TruongTanNghia/xe-tu-hanh-1-7-safe-corridor/sim_ws/src/rc_description/meshes/cage.stl

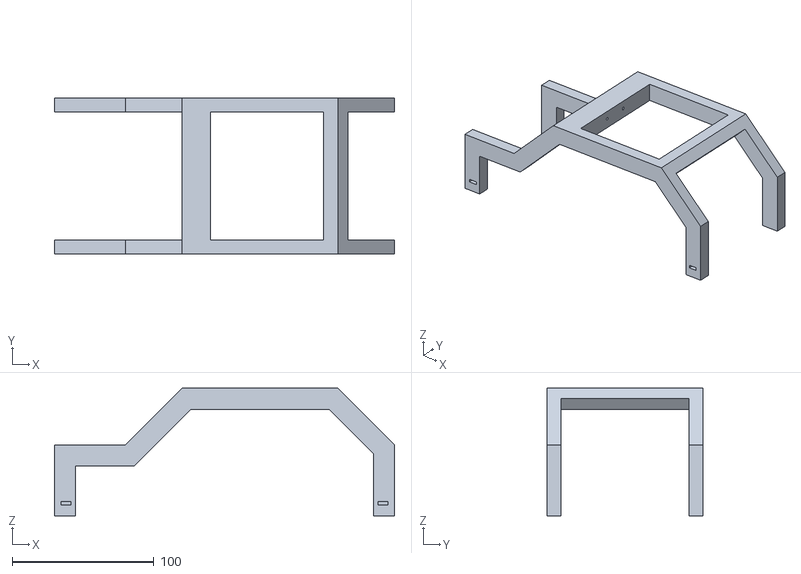
[picture p5: CAD file, 2026-10-25]
sim_ws/src/rc_description/meshes/cage.stl
240.0 x 110.0 x 90.0
