TruongTanNghia/xe-tu-hanh-1-7-safe-corridor/sim_ws/src/rc_description/meshes/chassis.stl

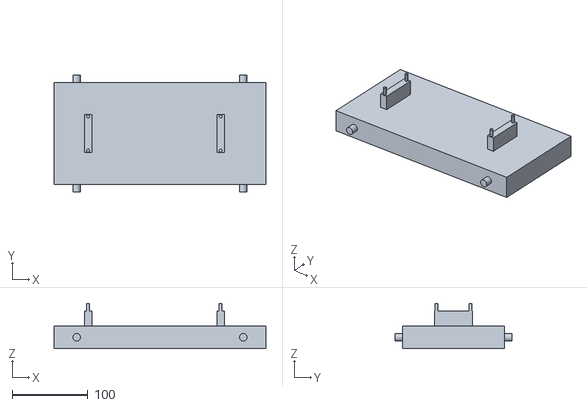
[picture p6: CAD file, 2026-10-25]
sim_ws/src/rc_description/meshes/chassis.stl
280.0 x 155.0 x 60.0
