TruongTanNghia/xe-tu-hanh-1-7-safe-corridor/sim_ws/src/rc_description/meshes/wheel_front_left.stl

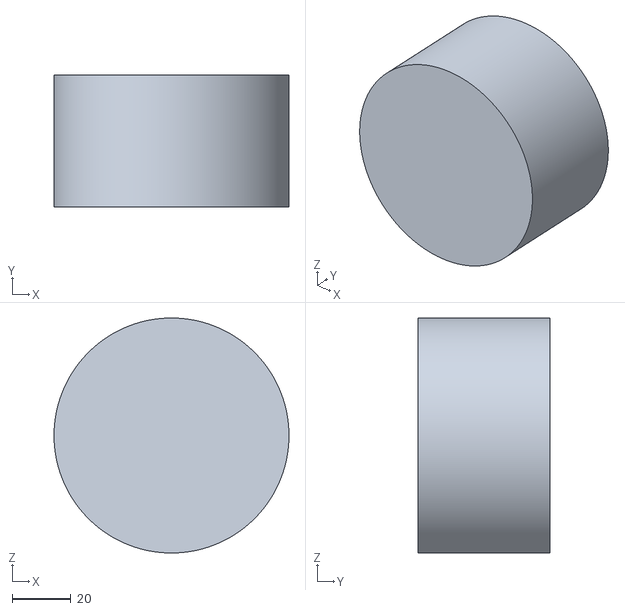
[picture p8: CAD file, 2026-10-25]
sim_ws/src/rc_description/meshes/wheel_front_left.stl
80.0 x 45.0 x 80.0
