TruongTanNghia/xe-tu-hanh-1-7-safe-corridor/(commit log)

2026-10-23 Sim: shared track module, ROS-free matplotlib viewer (sim_view), triggered pedestrian crossing; corridor: swept region for dynamic obstacles, capped prediction; FSM stop distance 1.2 m
    Verified headless in ros:humble Docker (tour scenario, 2 laps, no errors).
2026-10-25 Gazebo Classic demo (sim_ws: rc_description, rc_control, rc_gazebo_corridor with LiDAR, two-lane track, obstacles); corridor_follower; position-triggered scenario obstacles; docs: gazebo guide + para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
    Verified headless in Docker (ros:humble + Gazebo 11): tour scenario, 3 laps, stop before block, follow lead, no errors.
