TruongTanNghia/xe-tu-hanh-1-7-safe-corridor/(notices)

Notices in the files:
firmware/stm32/nucleo_f411re_microros/Src/main.c:
Copyright (c) 2026 STMicroelectronics.
All rights reserved.
This software is licensed under terms that can be found in the LICENSE file
